ele-kvadar/Sistem-1/SYS1.kicad_pcb

## KiCad design SYS1.kicad_pcb (2025-07-04)

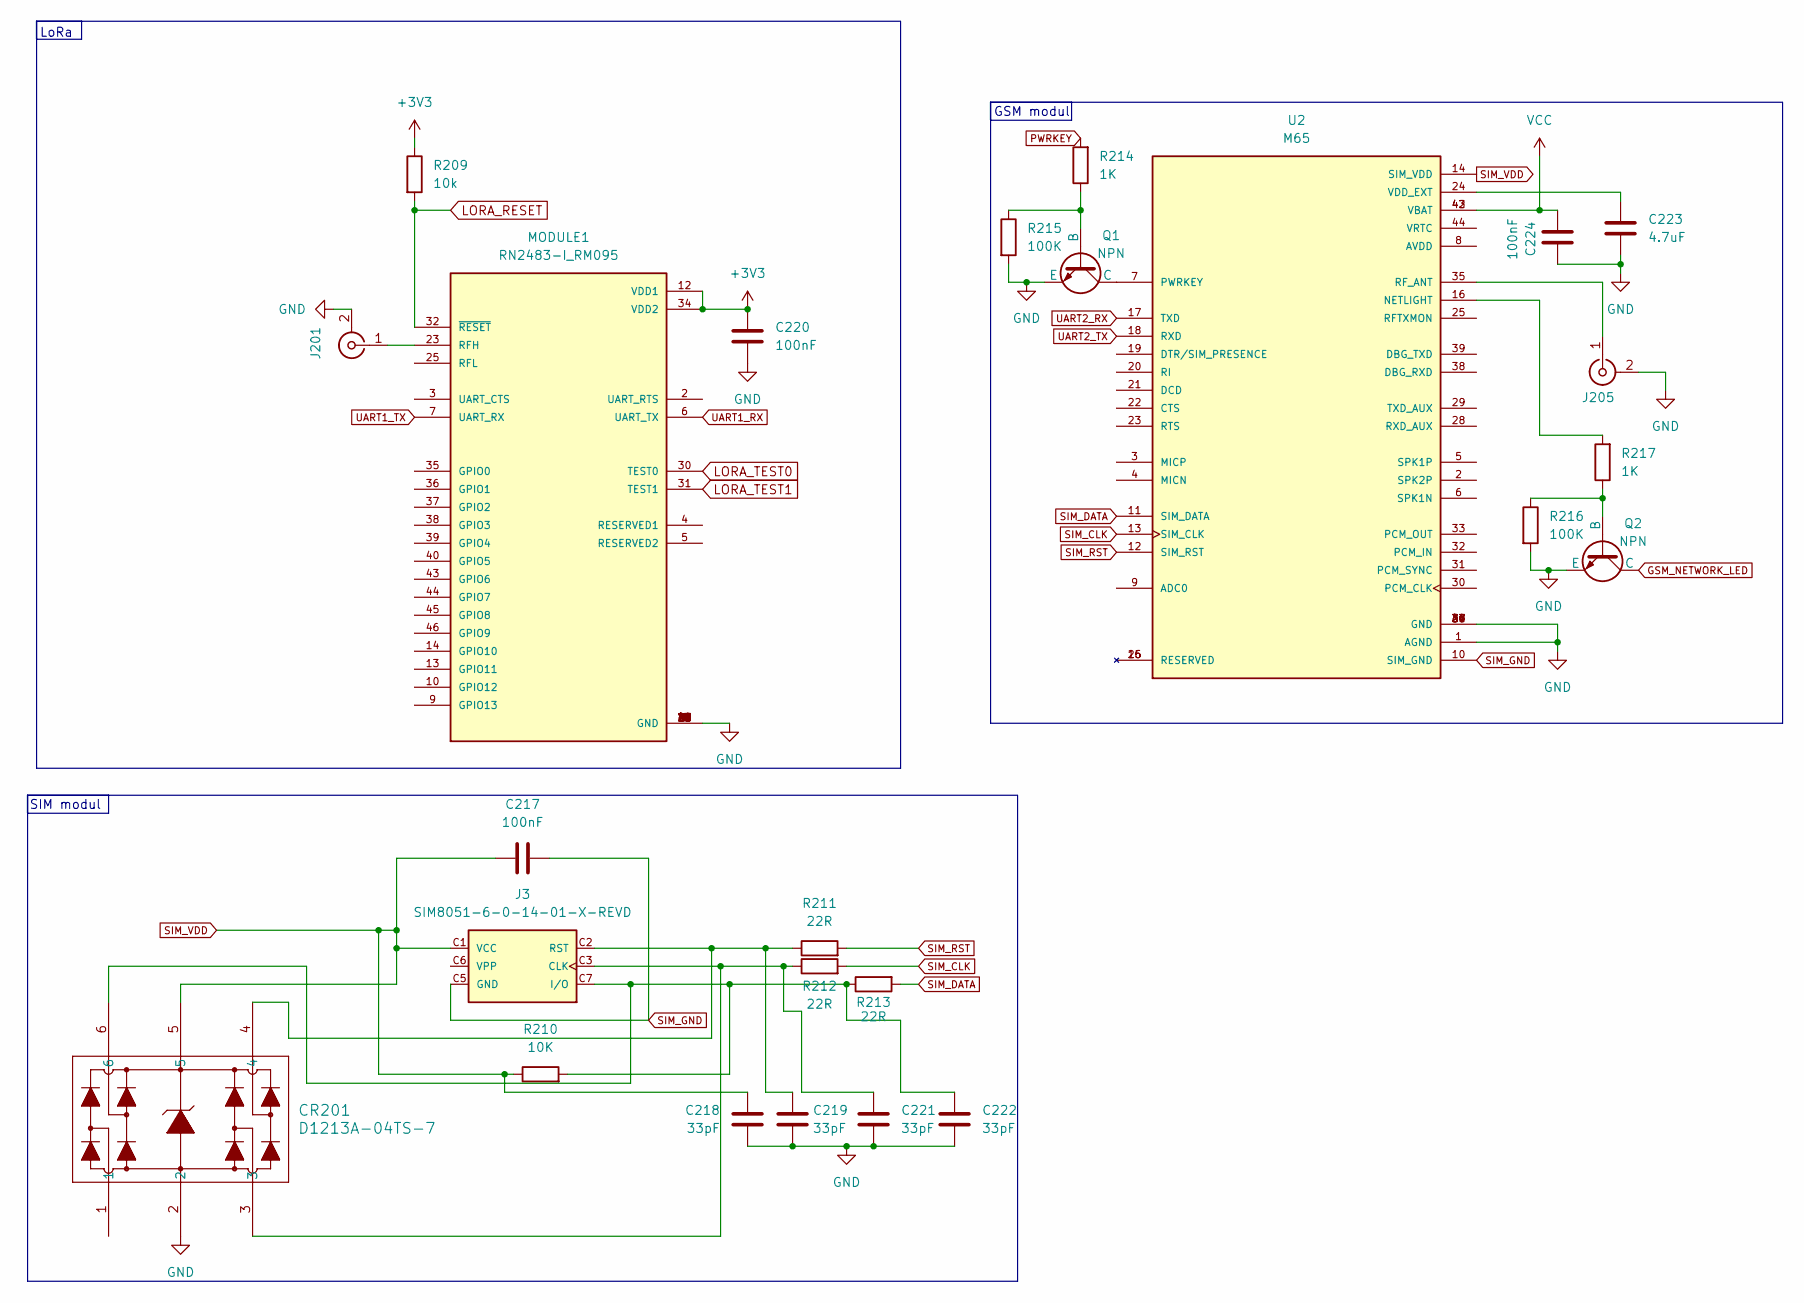
[picture p1: schematic Komunikacije.kicad_sch, ELEKvadar 2 - Sistem 1]

Parts:
C217, C220, C224: 100nF; C_1206_3216Metric_Pad1.33x1.80mm_HandSolder
C218, C219, C221, C222: 33pF; C_1206_3216Metric_Pad1.33x1.80mm_HandSolder
C223: 4.7uF; C_1206_3216Metric_Pad1.33x1.80mm_HandSolder
CR201: D1213A-04TS-7; TSOT26_DIO
J3: SIM8051-6-0-14-01-X-REVD; GCT_SIM8051-6-0-14-01-X-REVD
J201, J205: SMA_Amphenol_132134-16_Vertical
MODULE1: RN2483-I_RM095; MICROCHIP_RN2483-I_RM095
Q1, Q2: NPN; TSOT-23_HandSoldering
R209: 10k; R_1206_3216Metric_Pad1.30x1.75mm_HandSolder
R210: 10K; R_1206_3216Metric_Pad1.30x1.75mm_HandSolder
R211, R212, R213: 22R; R_1206_3216Metric_Pad1.30x1.75mm_HandSolder
R214, R217: 1K; R_1206_3216Metric_Pad1.30x1.75mm_HandSolder
R215, R216: 100K; R_1206_3216Metric_Pad1.30x1.75mm_HandSolder
U2: M65; XCVR_M65; PARTREV 1.0

Connections:
GND: C218.2, C219.2, C220.2, C221.2, C222.2, C223.1, C224.1, CR201.2, J201.2 (Ext), J205.2 (Ext), MODULE1.1 (GND), MODULE1.8 (GND), MODULE1.11 (GND), MODULE1.20 (GND), MODULE1.21 (GND), MODULE1.22 (GND), MODULE1.24 (GND), MODULE1.26 (GND), MODULE1.27 (GND), MODULE1.28 (GND), MODULE1.33 (GND), MODULE1.41 (GND), MODULE1.47 (GND), Q1.3 (E), Q2.3 (E), R215.2, R216.2, U2.1 (AGND), U2.27 (GND), U2.34 (GND), U2.36 (GND), U2.37 (GND), U2.40 (GND), U2.41 (GND); also elsewhere on the board
GSM_NETWORK_LED: Q2.1 (C); also elsewhere on the board
LORA_RESET: MODULE1.32 (~RESET), R209.2; also elsewhere on the board
LORA_TEST0: MODULE1.30 (TEST0); also elsewhere on the board
LORA_TEST1: MODULE1.31 (TEST1); also elsewhere on the board
unnamed: C221.1, CR201.3, J3.C3 (CLK), R212.1
unnamed: C222.1, CR201.6, J3.C7 (I/O), R210.2, R213.1
unnamed: C219.1, CR201.4, J3.C2 (RST), R211.1
unnamed: J201.1 (In), MODULE1.23 (RFH)
unnamed: J205.1 (In), U2.35 (RF_ANT)
unnamed: Q1.2 (B), R214.1, R215.1
unnamed: Q1.1 (C), U2.7 (PWRKEY)
unnamed: Q2.2 (B), R216.1, R217.1
unnamed: R217.2, U2.16 (NETLIGHT)
unnamed: C223.2, U2.24 (VDD_EXT)
PWRKEY: R214.2; also elsewhere on the board
SIM_CLK: R212.2, U2.13 (SIM_CLK)
SIM_DATA: R213.2, U2.11 (SIM_DATA)
SIM_GND: C217.2, J3.C5 (GND), U2.10 (SIM_GND)
SIM_RST: R211.2, U2.12 (SIM_RST)
SIM_VDD: C217.1, C218.1, CR201.5, J3.C1 (VCC), R210.1, U2.14 (SIM_VDD)
UART1_RX: MODULE1.6 (UART_TX); also elsewhere on the board
UART1_TX: MODULE1.7 (UART_RX); also elsewhere on the board
UART2_RX: U2.17 (TXD); also elsewhere on the board
UART2_TX: U2.18 (RXD); also elsewhere on the board
VCC: C224.2, U2.42 (VBAT), U2.43 (VBAT); also elsewhere on the board
VDDA: C220.1, MODULE1.12 (VDD1), MODULE1.34 (VDD2), R209.1; also elsewhere on the board

Notes on the sheet:
SIM modul
GSM modul
LoRa

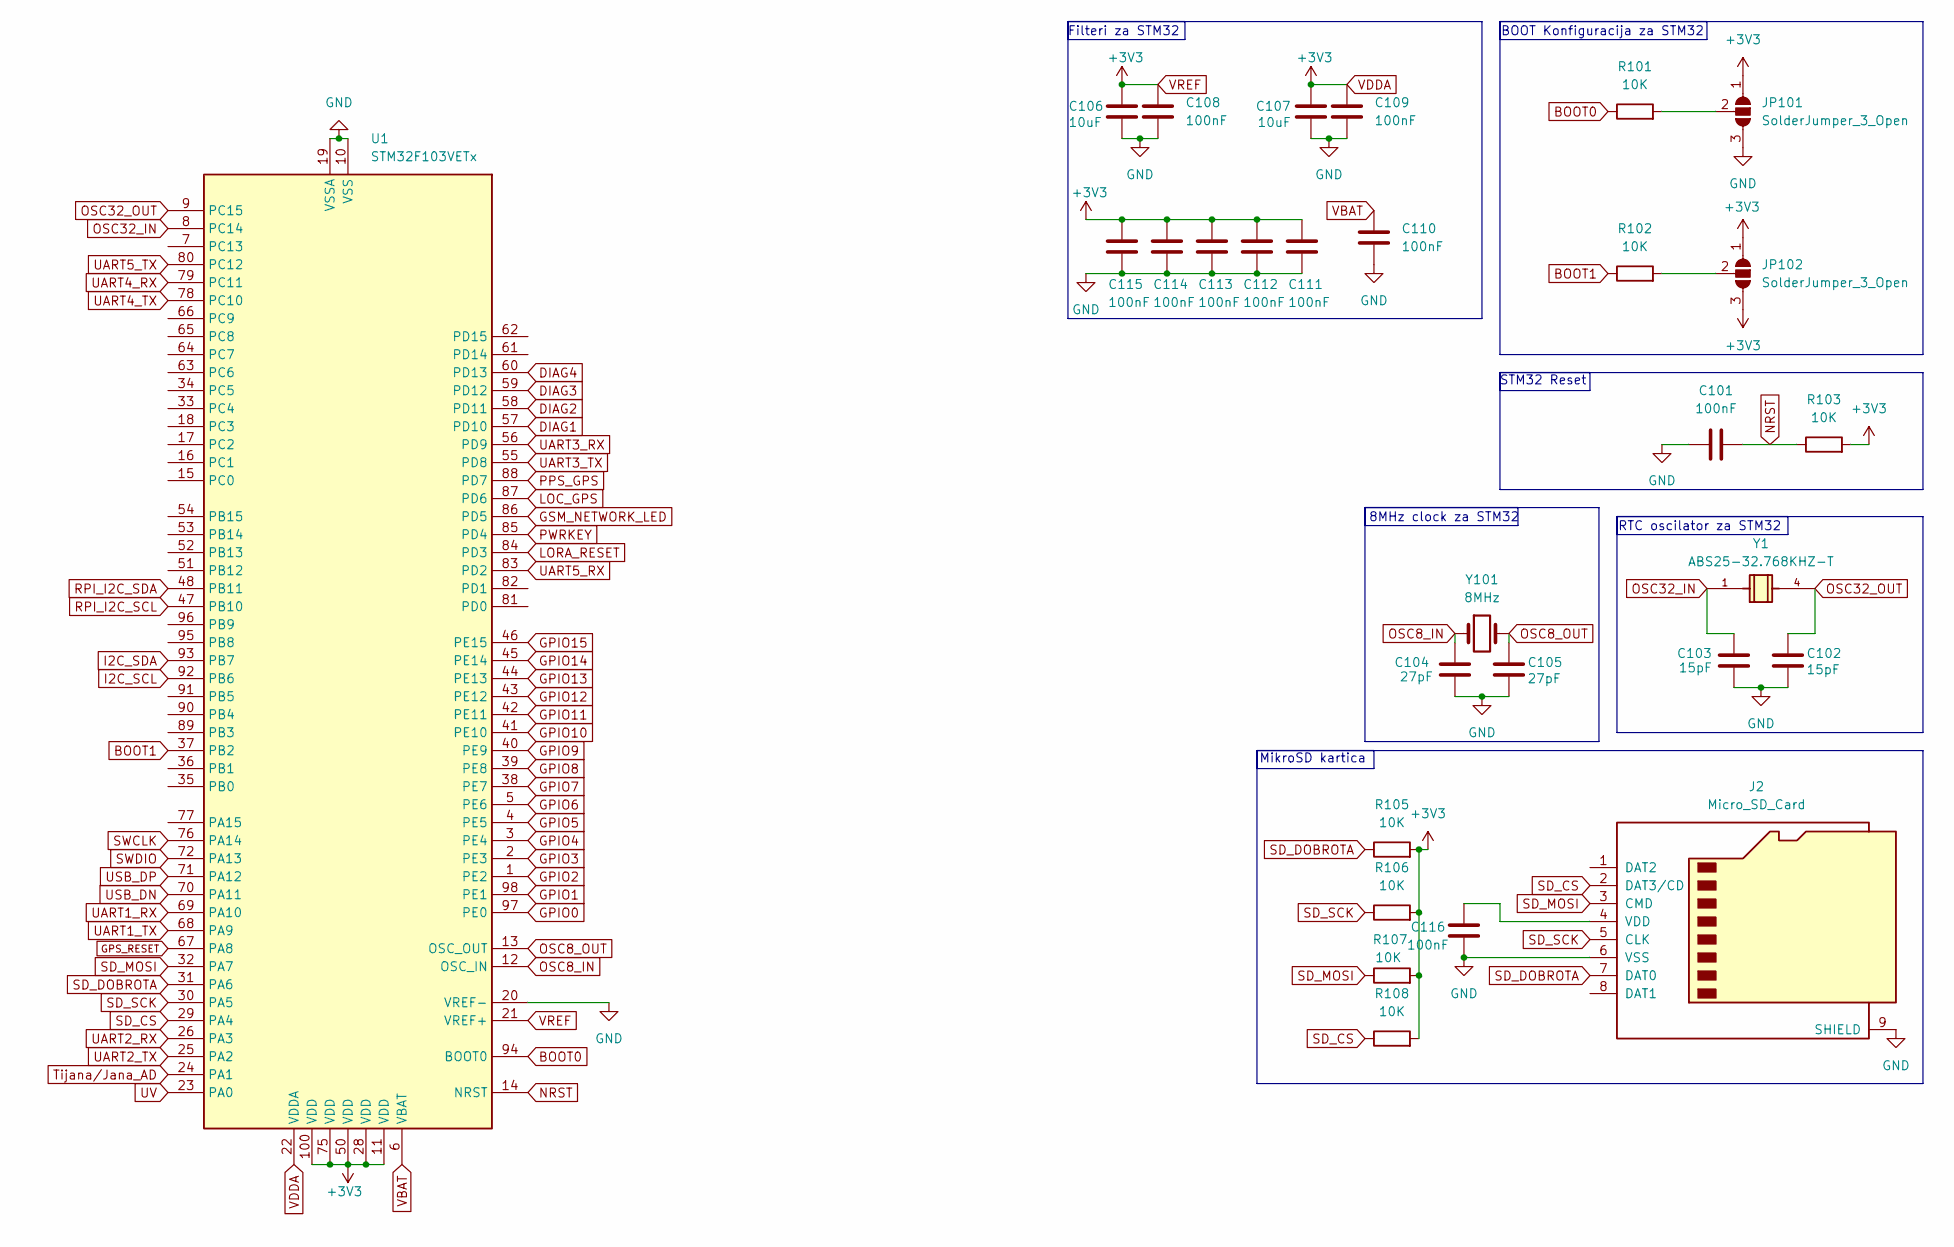
[picture p2: schematic stm32.kicad_sch, ELEKvadar 2 - Sistem 1]

Parts:
C101, C108, C109, C110, C111, C112, C113, C114, C115, C116: 100nF; C_1206_3216Metric_Pad1.33x1.80mm_HandSolder
C102, C103: 15pF; C_1206_3216Metric_Pad1.33x1.80mm_HandSolder
C104, C105: 27pF; C_1206_3216Metric_Pad1.33x1.80mm_HandSolder
C106, C107: 10uF; C_1206_3216Metric_Pad1.33x1.80mm_HandSolder
J2: Micro_SD_Card; microSD_HC_Molex_47219-2001
JP101, JP102: SolderJumper_3_Open; SolderJumper-3_P1.3mm_Open_RoundedPad1.0x1.5mm
R101, R102, R103, R105, R106, R107, R108: 10K; R_1206_3216Metric_Pad1.30x1.75mm_HandSolder
U1: STM32F103VETx; LQFP-100_14x14mm_P0.5mm
Y1: ABS25-32.768KHZ-T; Crystal_SMD_Abracon_ABS25-4Pin_8.0x3.8mm; PARTREV 12.01.15
Y101: 8MHz; Crystal_SMD_HC49-SD

Connections:
BOOT0: R101.1, U1.94 (BOOT0)
BOOT1: R102.1, U1.37 (PB2)
DIAG1: U1.57 (PD10); also elsewhere on the board
DIAG2: U1.58 (PD11); also elsewhere on the board
DIAG3: U1.59 (PD12); also elsewhere on the board
DIAG4: U1.60 (PD13); also elsewhere on the board
GND: C101.1, C102.2, C103.2, C104.2, C105.2, C106.2, C107.2, C108.1, C109.1, C110.1, C111.1, C112.1, C113.1, C114.1, C115.1, C116.1, J2.6 (VSS), J2.9 (SHIELD), JP101.3 (B), U1.10 (VSS), U1.19 (VSSA), U1.20 (VREF-), U1.27 (VSS), U1.49 (VSS), U1.74 (VSS), U1.99 (VSS); also elsewhere on the board
GPIO0: U1.97 (PE0); also elsewhere on the board
GPIO1: U1.98 (PE1); also elsewhere on the board
GPIO2: U1.1 (PE2); also elsewhere on the board
GPIO3: U1.2 (PE3); also elsewhere on the board
GPIO4: U1.3 (PE4); also elsewhere on the board
GPIO5: U1.4 (PE5); also elsewhere on the board
GPIO6: U1.5 (PE6); also elsewhere on the board
GPIO7: U1.38 (PE7); also elsewhere on the board
GPIO8: U1.39 (PE8); also elsewhere on the board
GPIO9: U1.40 (PE9); also elsewhere on the board
GPIO10: U1.41 (PE10); also elsewhere on the board
GPIO11: U1.42 (PE11); also elsewhere on the board
GPIO12: U1.43 (PE12); also elsewhere on the board
GPIO13: U1.44 (PE13); also elsewhere on the board
GPIO14: U1.45 (PE14); also elsewhere on the board
GPIO15: U1.46 (PE15); also elsewhere on the board
GPS_RESET: U1.67 (PA8); also elsewhere on the board
GSM_NETWORK_LED: U1.86 (PD5); also elsewhere on the board
I2C_SCL: U1.92 (PB6); also elsewhere on the board
I2C_SDA: U1.93 (PB7); also elsewhere on the board
LOC_GPS: U1.87 (PD6); also elsewhere on the board
LORA_RESET: U1.84 (PD3); also elsewhere on the board
NRST: C101.2, R103.1, U1.14 (NRST); also elsewhere on the board
unnamed: C116.2, J2.4 (VDD)
unnamed: JP101.2 (C), R101.2
unnamed: JP102.2 (C), R102.2
OSC8_IN: C104.1, U1.12 (OSC_IN), Y101.1
OSC8_OUT: C105.1, U1.13 (OSC_OUT), Y101.2
OSC32_IN: C103.1, U1.8 (PC14), Y1.1
OSC32_OUT: C102.1, U1.9 (PC15), Y1.4
PPS_GPS: U1.88 (PD7); also elsewhere on the board
PWRKEY: U1.85 (PD4); also elsewhere on the board
RPI_I2C_SCL: U1.47 (PB10); also elsewhere on the board
RPI_I2C_SDA: U1.48 (PB11); also elsewhere on the board
SD_CS: J2.2 (DAT3/CD), R108.1, U1.29 (PA4); also elsewhere on the board
SD_DOBROTA: J2.7 (DAT0), R105.1, U1.31 (PA6); also elsewhere on the board
SD_MOSI: J2.3 (CMD), R107.1, U1.32 (PA7); also elsewhere on the board
SD_SCK: J2.5 (CLK), R106.1, U1.30 (PA5); also elsewhere on the board
SWCLK: U1.76 (PA14); also elsewhere on the board
SWDIO: U1.72 (PA13); also elsewhere on the board
Tijana/Jana_AD: U1.24 (PA1); also elsewhere on the board
UART1_RX: U1.69 (PA10); also elsewhere on the board
UART1_TX: U1.68 (PA9); also elsewhere on the board
UART2_RX: U1.26 (PA3); also elsewhere on the board
UART2_TX: U1.25 (PA2); also elsewhere on the board
UART3_RX: U1.56 (PD9); also elsewhere on the board
UART3_TX: U1.55 (PD8); also elsewhere on the board
UART4_RX: U1.79 (PC11); also elsewhere on the board
UART4_TX: U1.78 (PC10); also elsewhere on the board
UART5_RX: U1.83 (PD2); also elsewhere on the board
UART5_TX: U1.80 (PC12); also elsewhere on the board
USB_DN: U1.70 (PA11); also elsewhere on the board
USB_DP: U1.71 (PA12); also elsewhere on the board
UV: U1.23 (PA0); also elsewhere on the board
VBAT: C110.2, U1.6 (VBAT); also elsewhere on the board
VDDA: C106.1, C107.1, C108.2, C109.2, C111.2, C112.2, C113.2, C114.2, C115.2, JP101.1 (A), JP102.1 (A), JP102.3 (B), R103.2, R105.2, R106.2, R107.2, R108.2, U1.11 (VDD), U1.21 (VREF+), U1.22 (VDDA), U1.28 (VDD), U1.50 (VDD), U1.75 (VDD), U1.100 (VDD); also elsewhere on the board

Notes on the sheet:
STM32 Reset
BOOT Konfiguracija za STM32
8MHz clock za STM32
Filteri za STM32
RTC oscilator za STM32
MikroSD kartica

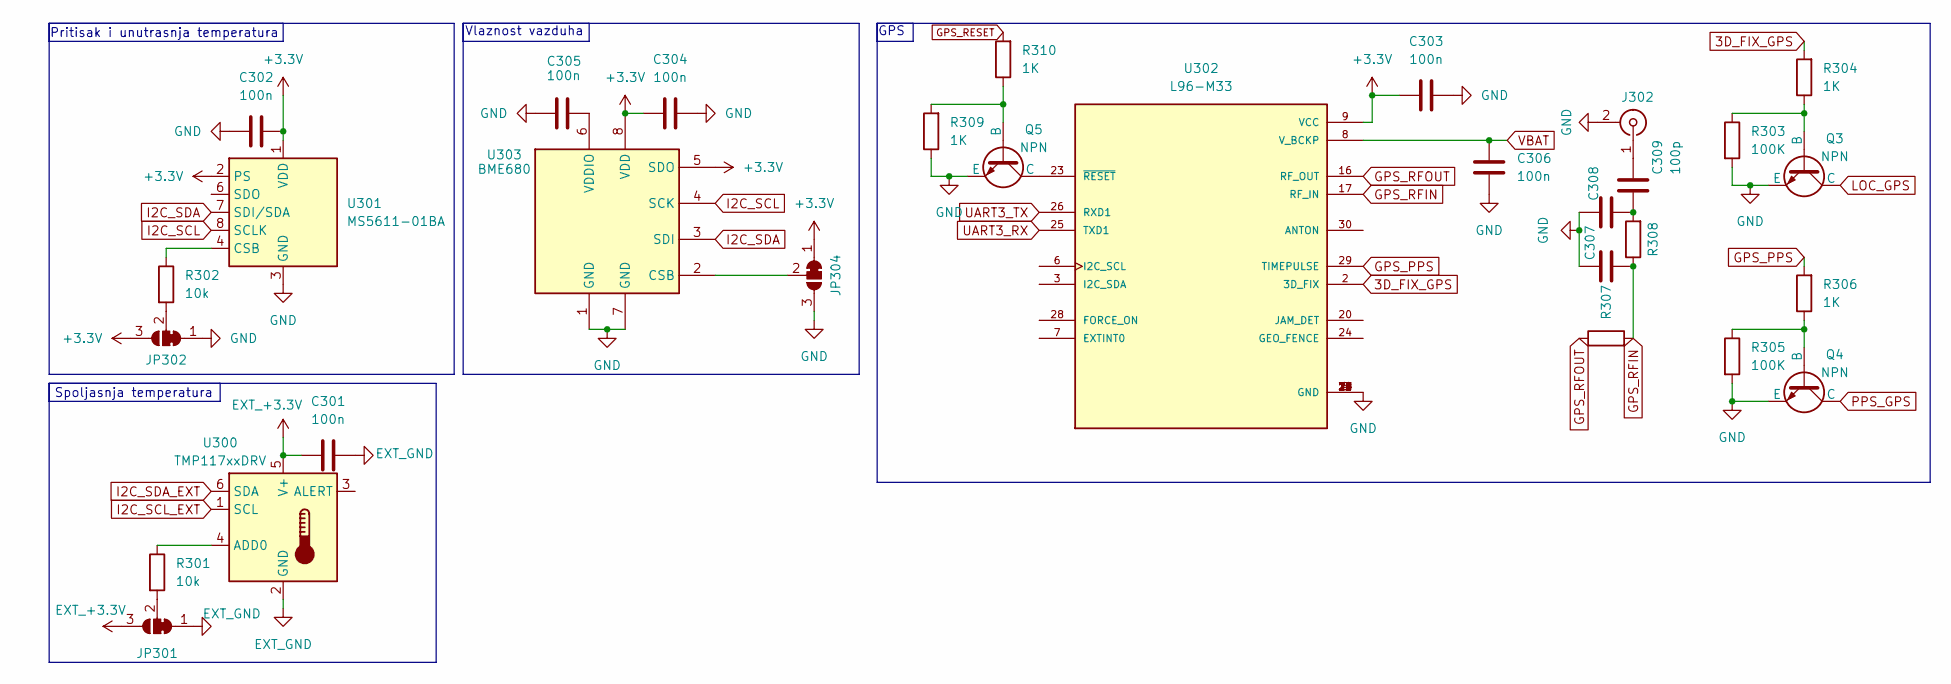
[picture p3: schematic senzori.kicad_sch, ELEKvadar 2 - Sistem 1]

Parts:
C301, C302, C303, C304, C305, C306: 100n; C_1206_3216Metric_Pad1.33x1.80mm_HandSolder
C307, C308: 0; C_1206_3216Metric_Pad1.33x1.80mm_HandSolder
C309: 100p; C_1206_3216Metric_Pad1.33x1.80mm_HandSolder
J302: SMA_Amphenol_132134-16_Vertical
JP301, JP302, JP304: SolderJumper_3_Bridged12; SolderJumper-3_P1.3mm_Bridged12_RoundedPad1.0x1.5mm
Q3, Q4, Q5: NPN; TSOT-23_HandSoldering
R301, R302: 10k; R_1206_3216Metric_Pad1.30x1.75mm_HandSolder
R303, R305: 100K; R_1206_3216Metric_Pad1.30x1.75mm_HandSolder
R304, R306, R309, R310: 1K; R_1206_3216Metric_Pad1.30x1.75mm_HandSolder
R307, R308: 0; R_1206_3216Metric_Pad1.30x1.75mm_HandSolder
U300: TMP117xxDRV; WSON-6-1EP_2x2mm_P0.65mm_EP1x1.6mm
U301: MS5611-01BA; LGA-8_3x5mm_P1.25mm
U302: L96-M33; Quectel_L96
U303: BME680; Bosch_LGA-8_3x3mm_P0.8mm_ClockwisePinNumbering

Connections:
3D_FIX_GPS: R304.2, U302.2 (3D_FIX)
+3.3V: C302.2, C303.1, C304.1, JP302.3 (B), JP304.1 (A), U301.1 (VDD), U301.2 (PS), U302.9 (VCC), U303.5 (SDO), U303.8 (VDD); also elsewhere on the board
EXT_+3.3V: C301.1, JP301.3 (B), U300.5 (V+); also elsewhere on the board
EXT_GND: C301.2, JP301.1 (A), U300.2 (GND); also elsewhere on the board
GND: C302.1, C303.2, C304.2, C305.2, C306.2, C307.1, C308.1, J302.2 (Ext), JP302.1 (A), JP304.3 (B), Q3.3 (E), Q4.3 (E), Q5.3 (E), R303.2, R305.2, R309.1, U301.3 (GND), U302.4 (GND), U302.5 (GND), U302.10 (GND), U302.11 (GND), U302.12 (GND), U302.13 (GND), U302.14 (GND), U302.15 (GND), U302.18 (GND), U302.19 (GND), U302.21 (GND), U302.22 (GND), U302.27 (GND), U302.31 (GND), U303.1 (GND), U303.7 (GND); also elsewhere on the board
GPS_PPS: R306.2, U302.29 (TIMEPULSE)
GPS_RESET: R310.2; also elsewhere on the board
GPS_RFIN: C307.2, R307.2, R308.1, U302.17 (RF_IN)
GPS_RFOUT: R307.1, U302.16 (RF_OUT)
I2C_SCL: U301.8 (SCLK), U303.4 (SCK); also elsewhere on the board
I2C_SCL_EXT: U300.1 (SCL); also elsewhere on the board
I2C_SDA: U301.7 (SDI/SDA), U303.3 (SDI); also elsewhere on the board
I2C_SDA_EXT: U300.6 (SDA); also elsewhere on the board
LOC_GPS: Q3.1 (C); also elsewhere on the board
unnamed: C308.2, C309.2, R308.2
unnamed: C309.1, J302.1 (In)
unnamed: JP301.2 (C), R301.2
unnamed: JP302.2 (C), R302.2
unnamed: JP304.2 (C), U303.2 (CSB)
unnamed: Q3.2 (B), R303.1, R304.1
unnamed: Q4.2 (B), R305.1, R306.1
unnamed: Q5.2 (B), R309.2, R310.1
unnamed: Q5.1 (C), U302.23 (~RESET)
unnamed: R302.1, U301.4 (CSB), U301.5 (CSB)
unnamed: R301.1, U300.4 (ADD0)
unnamed: C305.1, U303.6 (VDDIO)
PPS_GPS: Q4.1 (C); also elsewhere on the board
UART3_RX: U302.25 (TXD1); also elsewhere on the board
UART3_TX: U302.26 (RXD1); also elsewhere on the board
VBAT: C306.1, U302.8 (V_BCKP); also elsewhere on the board

Notes on the sheet:
GPS
Vlaznost vazduha
Pritisak i unutrasnja temperatura
Spoljasnja temperatura

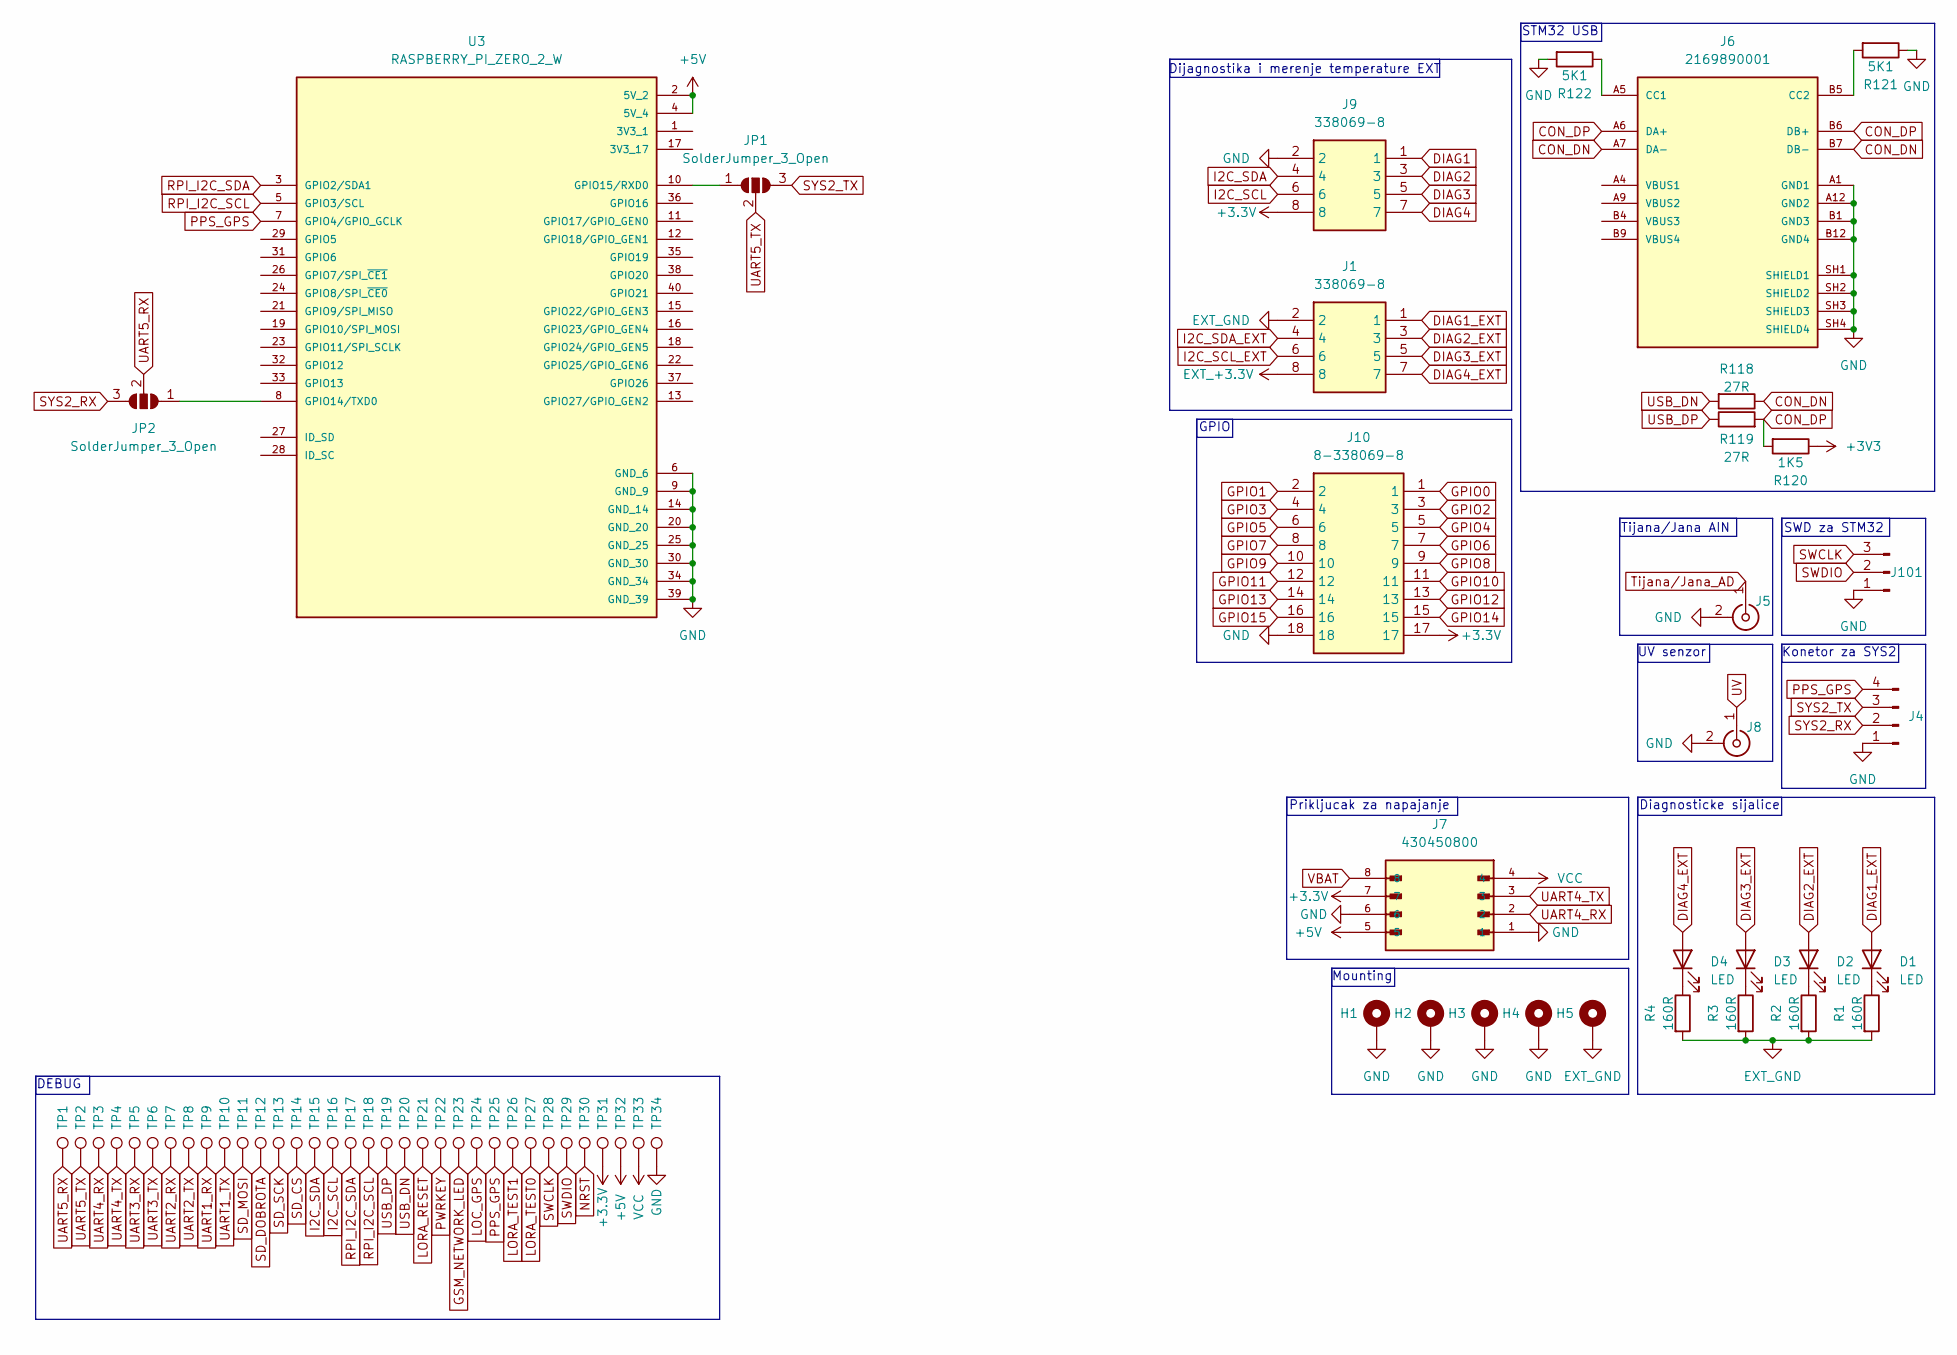
[picture p4: schematic rpi.kicad_sch, ELEKvadar 2 - Sistem 1]

Parts:
D1, D2, D3, D4: LED; LED_1206_3216Metric_Pad1.42x1.75mm_HandSolder
H1, H2, H3, H4, H5: MountingHole_Pad; MountingHole_3.2mm_M3_DIN965_Pad_TopBottom
J1, J9: 338069-8; 3380698; Mouser Part Number 571-338069-8
J4: Conn_01x04_Pin; Molex_Micro-Fit_3.0_43650-0400_1x04_P3.00mm_Horizontal
J5, J8: SMA_Amphenol_132134-16_Vertical
J6: 2169890001; MOLEX_2169890001; PARTREV B
J7: 430450800; MOLEX_430450800; PARTREV G
J10: 8-338069-8; 83380698; Manufacturer_Part_Number 8-338069-8; Mouser Part Number 571-8-338069-8
J101: Conn_01x03_Pin; PinHeader_1x03_P2.54mm_Vertical
JP1, JP2: SolderJumper_3_Open; SolderJumper-3_P1.3mm_Open_RoundedPad1.0x1.5mm
R1, R2, R3, R4: 160R; R_1206_3216Metric_Pad1.30x1.75mm_HandSolder
R118, R119: 27R; R_1206_3216Metric_Pad1.30x1.75mm_HandSolder
R120: 1K5; R_1206_3216Metric_Pad1.30x1.75mm_HandSolder
R121, R122: 5K1; R_1206_3216Metric_Pad1.30x1.75mm_HandSolder
TP1, TP2, TP3, TP4, TP5, TP6, TP7, TP8, TP9, TP10, TP11, TP12, TP13, TP14, TP15, TP16, TP17, TP18, TP19, TP20, TP21, TP22, TP23, TP24, TP25, TP26, TP27, TP28, TP29, TP30, TP31, TP32, TP33, TP34: TestPoint; TestPoint_Pad_D1.0mm
U3: RASPBERRY_PI_ZERO_2_W; MODULE_RASPBERRY_PI_ZERO_2_W; PARTREV April 2024

Connections:
+3.3V: J7.7, J9.8, J10.17, TP31.1; also elsewhere on the board
+5V: J7.5, TP32.1, U3.2 (5V_2), U3.4 (5V_4)
CON_DN: J6.A7 (DA-), J6.B7 (DB-), R118.1
CON_DP: J6.A6 (DA+), J6.B6 (DB+), R119.2, R120.2
DIAG1: J9.1; also elsewhere on the board
DIAG1_EXT: D1.2 (A), J1.1
DIAG2: J9.3; also elsewhere on the board
DIAG2_EXT: D2.2 (A), J1.3
DIAG3: J9.5; also elsewhere on the board
DIAG3_EXT: D3.2 (A), J1.5
DIAG4: J9.7; also elsewhere on the board
DIAG4_EXT: D4.2 (A), J1.7
EXT_+3.3V: J1.8; also elsewhere on the board
EXT_GND: H5.1, J1.2, R1.2, R2.2, R3.2, R4.2; also elsewhere on the board
GND: H1.1, H2.1, H3.1, H4.1, J4.1, J5.2 (Ext), J6.A1 (GND1), J6.A12 (GND2), J6.B1 (GND3), J6.B12 (GND4), J6.SH1 (SHIELD1), J6.SH2 (SHIELD2), J6.SH3 (SHIELD3), J6.SH4 (SHIELD4), J7.1, J7.6, J8.2 (Ext), J9.2, J10.18, J101.1, R121.1, R122.2, TP34.1, U3.6 (GND_6), U3.9 (GND_9), U3.14 (GND_14), U3.20 (GND_20), U3.25 (GND_25), U3.30 (GND_30), U3.34 (GND_34), U3.39 (GND_39); also elsewhere on the board
GPIO0: J10.1; also elsewhere on the board
GPIO1: J10.2; also elsewhere on the board
GPIO2: J10.3; also elsewhere on the board
GPIO3: J10.4; also elsewhere on the board
GPIO4: J10.5; also elsewhere on the board
GPIO5: J10.6; also elsewhere on the board
GPIO6: J10.7; also elsewhere on the board
GPIO7: J10.8; also elsewhere on the board
GPIO8: J10.9; also elsewhere on the board
GPIO9: J10.10; also elsewhere on the board
GPIO10: J10.11; also elsewhere on the board
GPIO11: J10.12; also elsewhere on the board
GPIO12: J10.13; also elsewhere on the board
GPIO13: J10.14; also elsewhere on the board
GPIO14: J10.15; also elsewhere on the board
GPIO15: J10.16; also elsewhere on the board
GSM_NETWORK_LED: TP23.1; also elsewhere on the board
I2C_SCL: J9.6, TP16.1; also elsewhere on the board
I2C_SCL_EXT: J1.6; also elsewhere on the board
I2C_SDA: J9.4, TP15.1; also elsewhere on the board
I2C_SDA_EXT: J1.4; also elsewhere on the board
LOC_GPS: TP24.1; also elsewhere on the board
LORA_RESET: TP21.1; also elsewhere on the board
LORA_TEST0: TP27.1; also elsewhere on the board
LORA_TEST1: TP26.1; also elsewhere on the board
NRST: TP30.1; also elsewhere on the board
unnamed: D1.1 (K), R1.1
unnamed: D2.1 (K), R2.1
unnamed: D3.1 (K), R3.1
unnamed: D4.1 (K), R4.1
unnamed: J6.A5 (CC1), R122.1
unnamed: J6.B5 (CC2), R121.2
unnamed: JP1.1 (A), U3.10 (GPIO15/RXD0)
unnamed: JP2.1 (A), U3.8 (GPIO14/TXD0)
PPS_GPS: J4.4, TP25.1, U3.7 (GPIO4/GPIO_GCLK); also elsewhere on the board
PWRKEY: TP22.1; also elsewhere on the board
RPI_I2C_SCL: TP18.1, U3.5 (GPIO3/SCL); also elsewhere on the board
RPI_I2C_SDA: TP17.1, U3.3 (GPIO2/SDA1); also elsewhere on the board
SD_CS: TP14.1; also elsewhere on the board
SD_DOBROTA: TP12.1; also elsewhere on the board
SD_MOSI: TP11.1; also elsewhere on the board
SD_SCK: TP13.1; also elsewhere on the board
SWCLK: J101.3, TP28.1; also elsewhere on the board
SWDIO: J101.2, TP29.1; also elsewhere on the board
SYS2_RX: J4.2, JP2.3 (B)
SYS2_TX: J4.3, JP1.3 (B)
Tijana/Jana_AD: J5.1 (In); also elsewhere on the board
UART1_RX: TP9.1; also elsewhere on the board
UART1_TX: TP10.1; also elsewhere on the board
UART2_RX: TP7.1; also elsewhere on the board
UART2_TX: TP8.1; also elsewhere on the board
UART3_RX: TP5.1; also elsewhere on the board
UART3_TX: TP6.1; also elsewhere on the board
UART4_RX: J7.2, TP3.1; also elsewhere on the board
UART4_TX: J7.3, TP4.1; also elsewhere on the board
UART5_RX: JP2.2 (C), TP1.1; also elsewhere on the board
UART5_TX: JP1.2 (C), TP2.1; also elsewhere on the board
USB_DN: R118.2, TP20.1; also elsewhere on the board
USB_DP: R119.1, TP19.1; also elsewhere on the board
UV: J8.1 (In); also elsewhere on the board
VBAT: J7.8; also elsewhere on the board
VCC: J7.4, TP33.1; also elsewhere on the board
VDDA: R120.1; also elsewhere on the board

Notes on the sheet:
SWD za STM32
Dijagnostika i merenje temperature EXT
DEBUG
Prikljucak za napajanje
Mounting
UV senzor
Konetor za SYS2
STM32 USB
Tijana/Jana AIN
GPIO
Diagnosticke sijalice

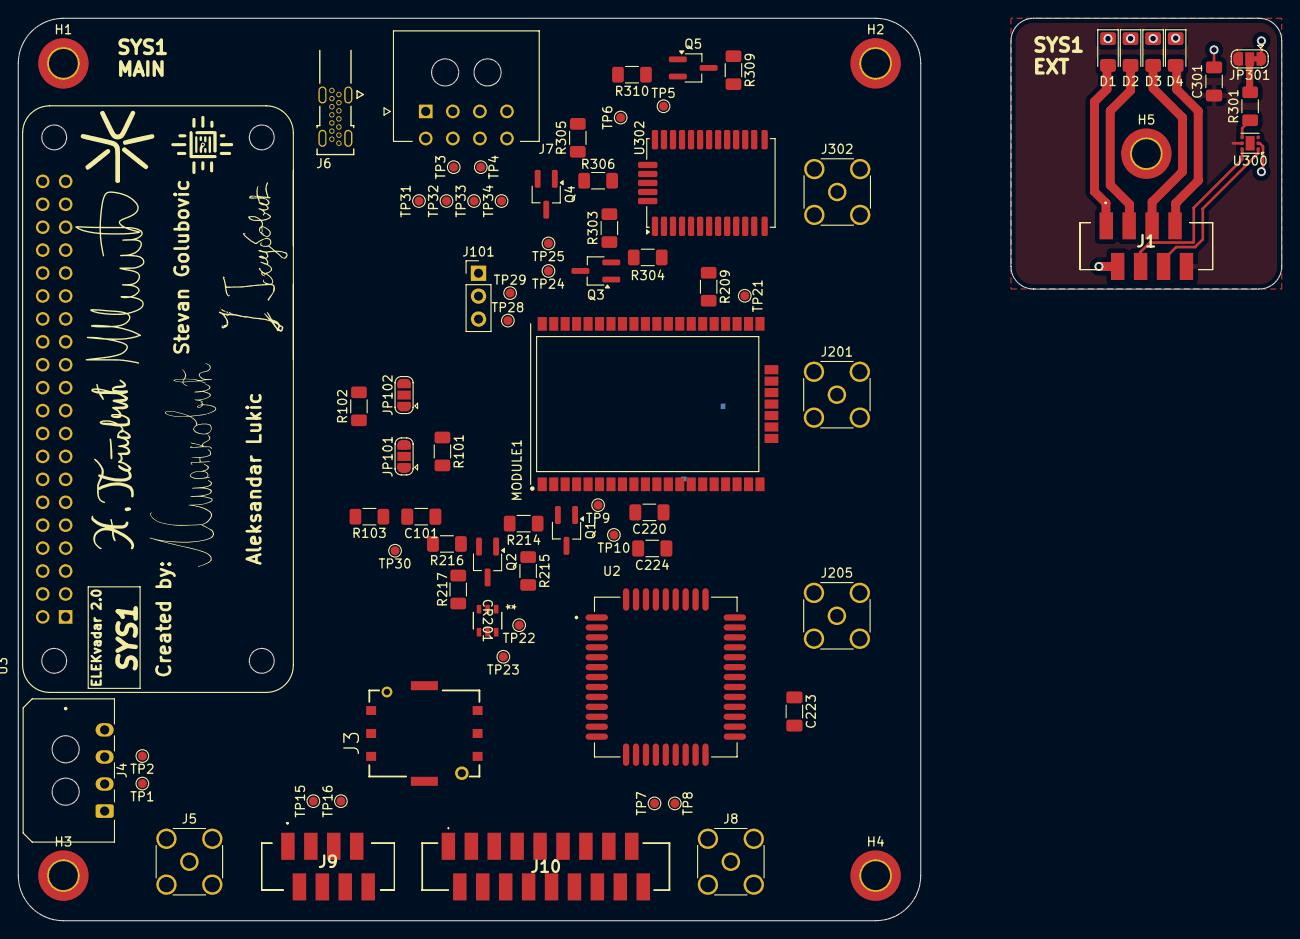
[picture p5: board SYS1.kicad_pcb from above]

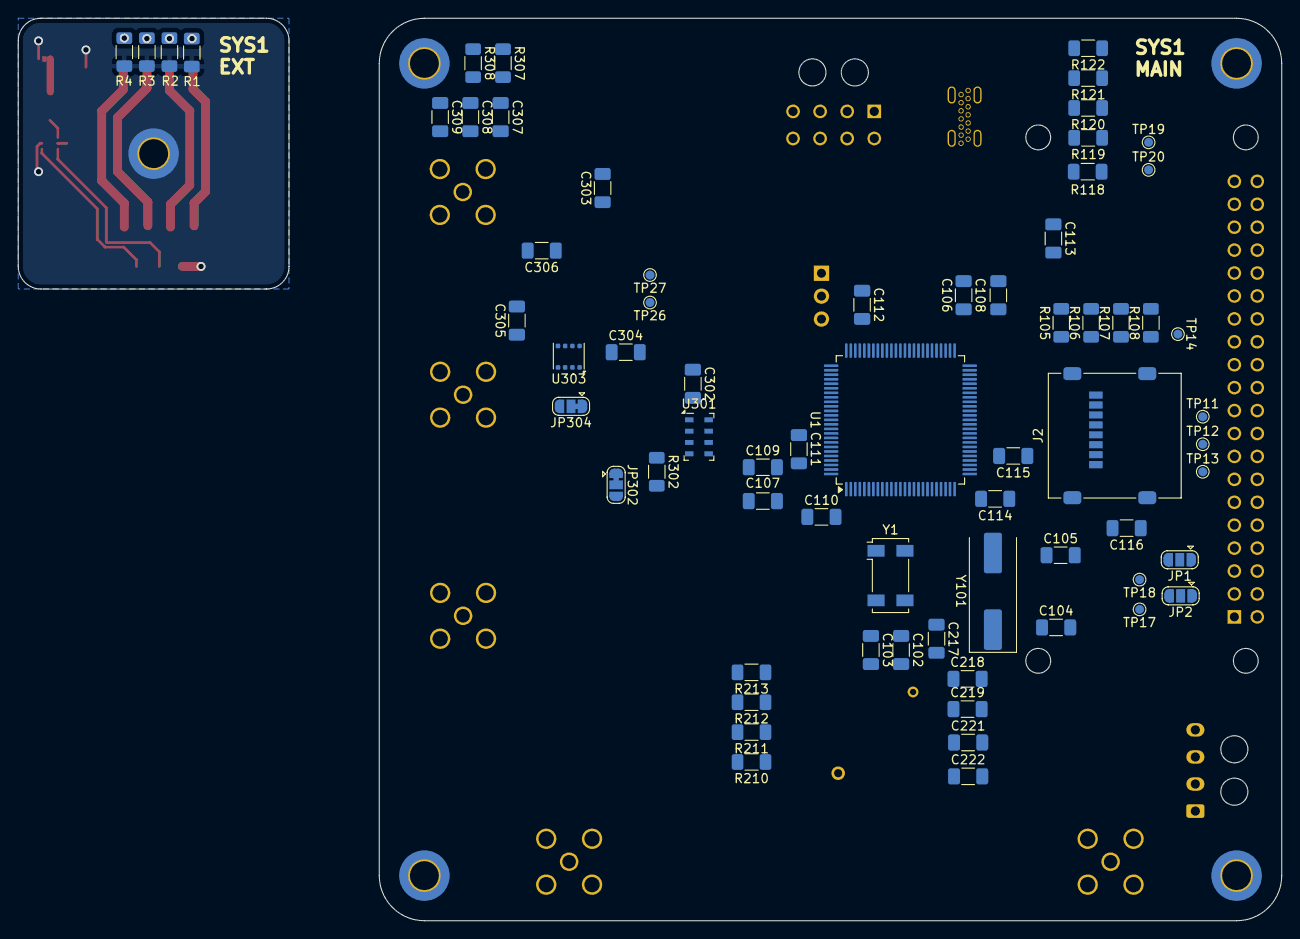
[picture p6: board SYS1.kicad_pcb from below]

Board: 4 copper layers, 100.0 x 100.0 mm, 148 parts (68 on the bottom side), 119 nets.
