ele-kvadar/Sistem-1/(commit log)

2025-05-30 Prva verzija seme
    Prva verzija sa svim semama objedinjenim bez pcb
    [Komunikacije.kicad_sch, SYS1.kicad_pcb, SYS1.kicad_sch, rpi.kicad_sch, senzori.kicad_sch, stm32.kicad_sch, tmp.kicad_sch]
2025-06-18 Pocetak PCB dizajna
    Dodao fizicke definicije ploce
    Dodao rupe za montazu
    Kreirao inicijalnijalni placement
    [SYS1.kicad_pcb, rpi.kicad_sch]
2025-06-18 Napajanje
    David i njegova biblioteka su pravili probleme
    [rpi.kicad_sch]
2025-06-18 manje izmene pcb layouta
    dodao konektor za napajanje
    [SYS1.kicad_pcb]
2025-06-19 Znacajne izmene seme
    Dodao prikljucak za UV senzor
    Dodao reset za GPS
    Dodao ext_ant za GPS
    Dodao 3D modele
    Dodao testpoint-e
    Sredio semu malo
    [SYS1.kicad_pcb, rpi.kicad_sch, senzori.kicad_sch, stm32.kicad_sch]
2025-06-19 H2 se pomerio i izmenio RPI footprint
    Pomerio mountng hole H2 da se poracna sa mounting hole na rpi
    Nova pozicija je 5mm od leve ivice 7mm od gornje
    Izmenio sam footprint za rpi da uklonim 2 rupe koje se nalaze na desnoj ivici zato sto nam nisu potrebne
    [SYS1.kicad_pcb]
2025-06-19 Manje izmene PCB
    Podesio plocu da bude 4 sloja
    [SYS1.kicad_pcb]
2025-06-19 Layout i rutiranje za EXT PCB uradjeni
    Uradio sam layout i rutiranje za plocicu sa sijalicama i senzorom temperature koja ce biti montirana napolju
    [SYS1.kicad_pcb, rpi.kicad_sch, senzori.kicad_sch]
2025-06-19 Dodata baterija
    Dodao pin za bateriju na konektor za napajanje
    [SYS1.kicad_pcb, rpi.kicad_sch]
2025-06-19 Manje izmene seme
    Sredio izgled seme
    [rpi.kicad_sch, senzori.kicad_sch]
2025-07-03 Znacajne izmene seme i pcb-a
    Napravljen nov layout
    dodat konektor za gpio
    dodat konektor za eksterna merenja vetra
    izmenjene diag lampice
    izmenjen konektor za ext plocu
    razno
    [SYS1.kicad_pcb, rpi.kicad_sch, senzori.kicad_sch, stm32.kicad_sch]
2025-07-04 Velike izmene PCB
    Zavrsena mala spoljanja plocica
    Preliminarni placement komponenti na velikoj plocici
    Dodati logotipi ISP i ELE
    Dodato potpise
    [SYS1.kicad_pcb, stm32.kicad_sch]
